iorodeo/uw_face_shield/README.md

## uw_face_shield  

Laser cutting design files for cutting the UW face shield.

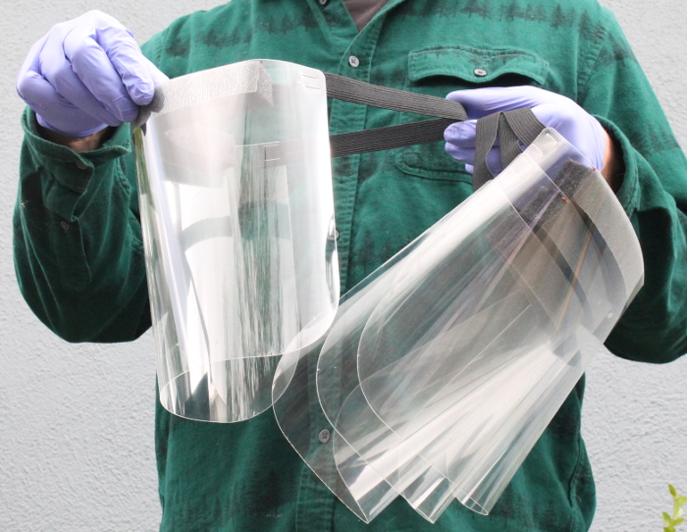
[picture p1: images/uw_shield_3.JPG]


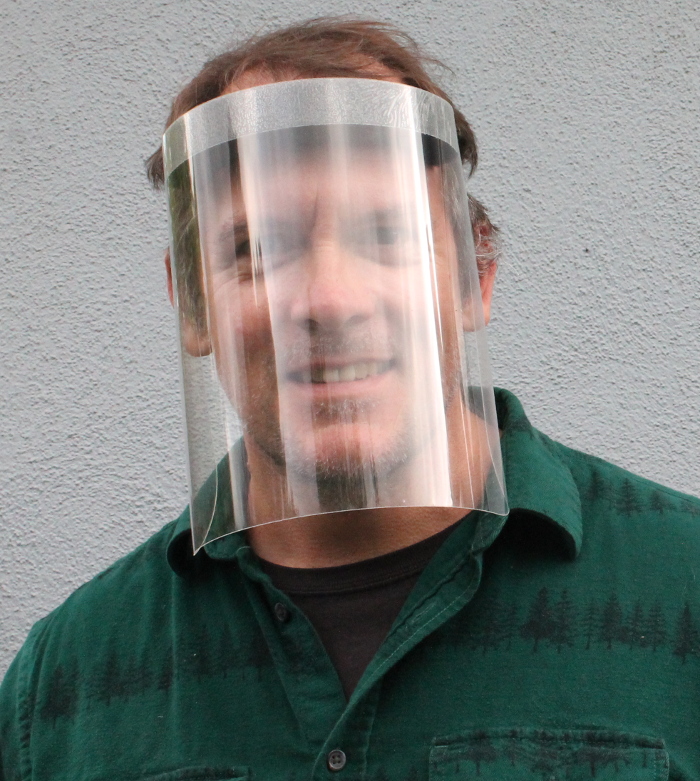
[picture p2: images/uw_shield_1.JPG]
