iorodeo/uw_face_shield/clear_shield.dxf

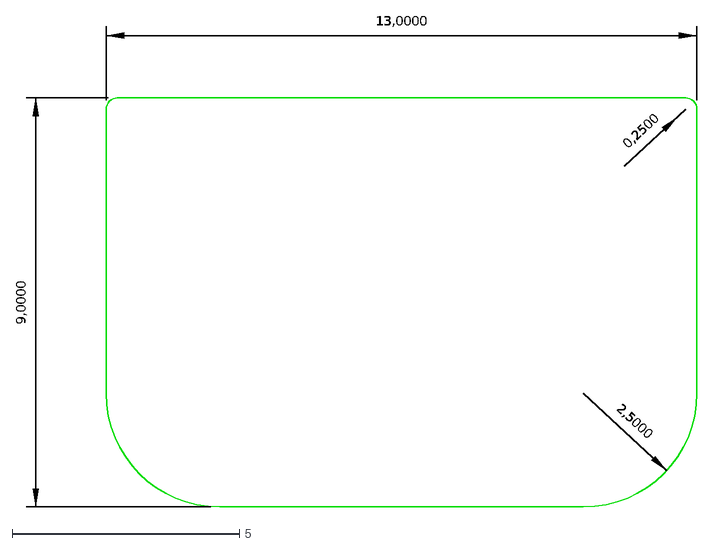
[picture p8: CAD file, 2020-03-24]
clear_shield.dxf
9,0000
13,0000
2,5000
0,2500
