iorodeo/uw_face_shield/lasercut/layout_clear_shield.dxf

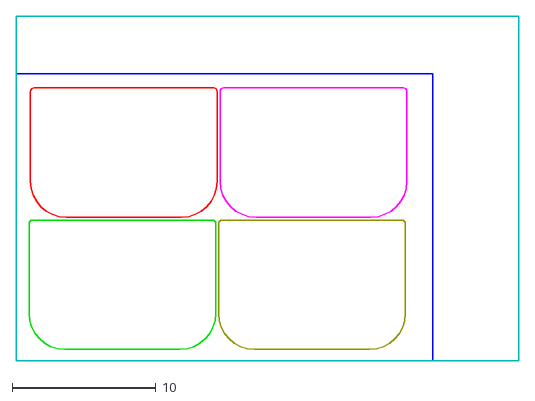
[picture p9: CAD file, 2020-03-24]
lasercut/layout_clear_shield.dxf
35.0 x 24.0
