iorodeo/uw_face_shield/(commit log)

2020-03-24 Project creation.
    [clear_shield.dxf, layout_clear_shield.dxf]
2020-03-24 Added gcode for laser cutting.
    [layout_clear_shield.dxf]
